cryptoAlgorithm/BatteryPod/BatteryPod.step

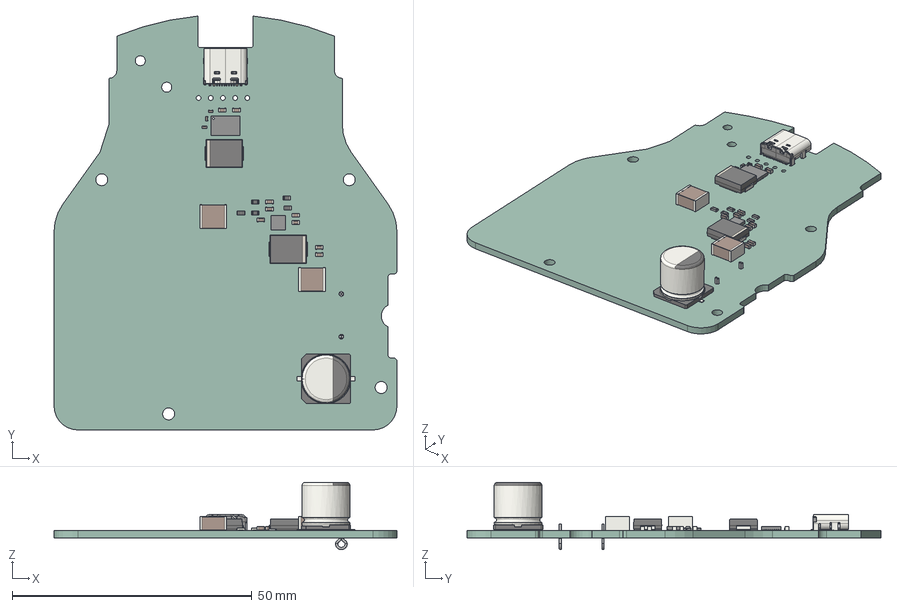
[picture p1: CAD file, 2024-05-07]
BatteryPod.step
71.5 x 86.3 x 14.0 mm
TPS25750DRJKR
C_0603_1608Metric x 9
RTE0016C_ASM
R_0603_1608Metric x 5
C_2220_5650Metric x 2
USB_C_Receptacle_16P_TopMnt_Horizontal_GCT_USB4105-xx-A
D_SMC x 2
C_0402_1005Metric x 3
CP_Elec_10x10
TestPoint_Loop_D2.50mm_Drill1.0mm_LowProfile x 2
BatteryPod_PCB
