cryptoAlgorithm/BatteryPod/3dModels/Coilcraft-SER2918H.STEP

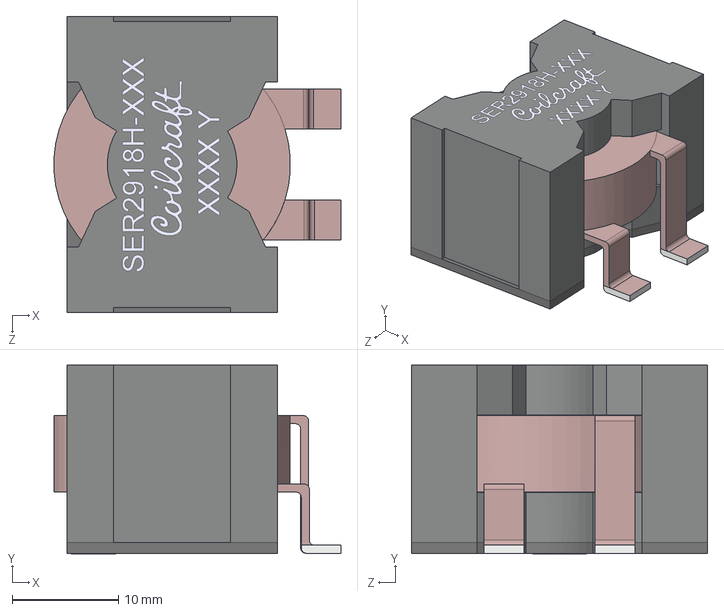
[picture p2: CAD file, 2024-05-01]
3dModels/Coilcraft-SER2918H.STEP
27.0 x 17.8 x 27.9 mm
