cryptoAlgorithm/BatteryPod/3dModels/RTE0016C.stp

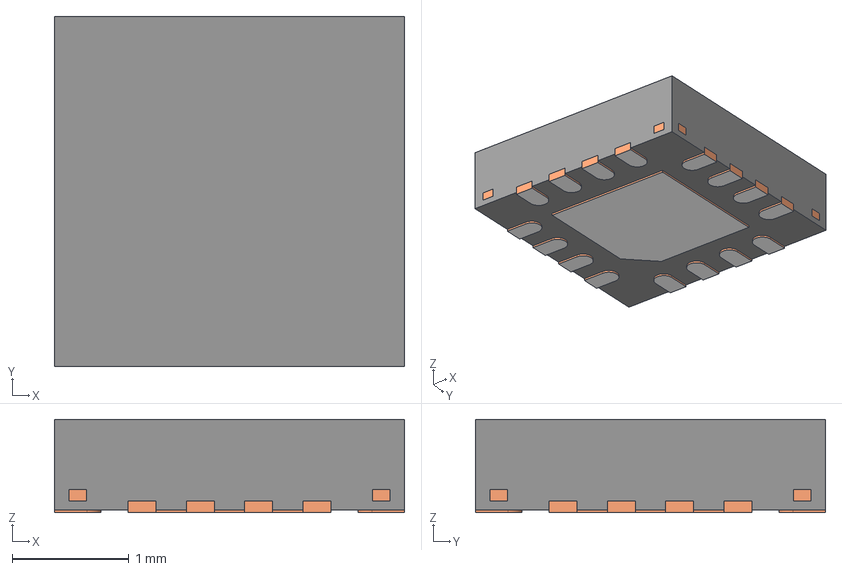
[picture p3: CAD file, 2024-04-30]
3dModels/RTE0016C.stp
3.00 x 3.00 x 0.8 mm
BODY-QFN
FRAME-RTE0016C
PIN1-ID
