cryptoAlgorithm/BatteryPod/3dModels/TPS25750DRJKR.step

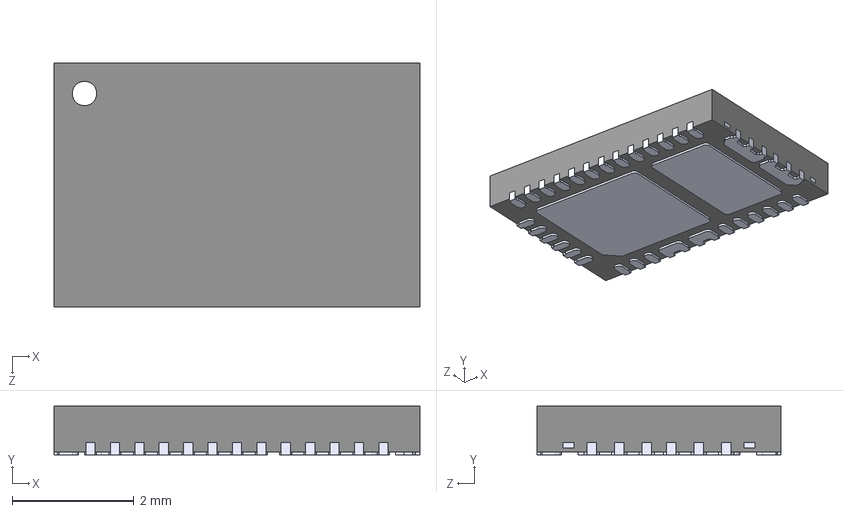
[picture p4: CAD file, 2024-05-06]
3dModels/TPS25750DRJKR.step
6.00 x 0.8 x 4.00 mm
