cryptoAlgorithm/BatteryPod/BatteryPod.kicad_pcb

## KiCad design BatteryPod.kicad_pcb (2024-05-26)

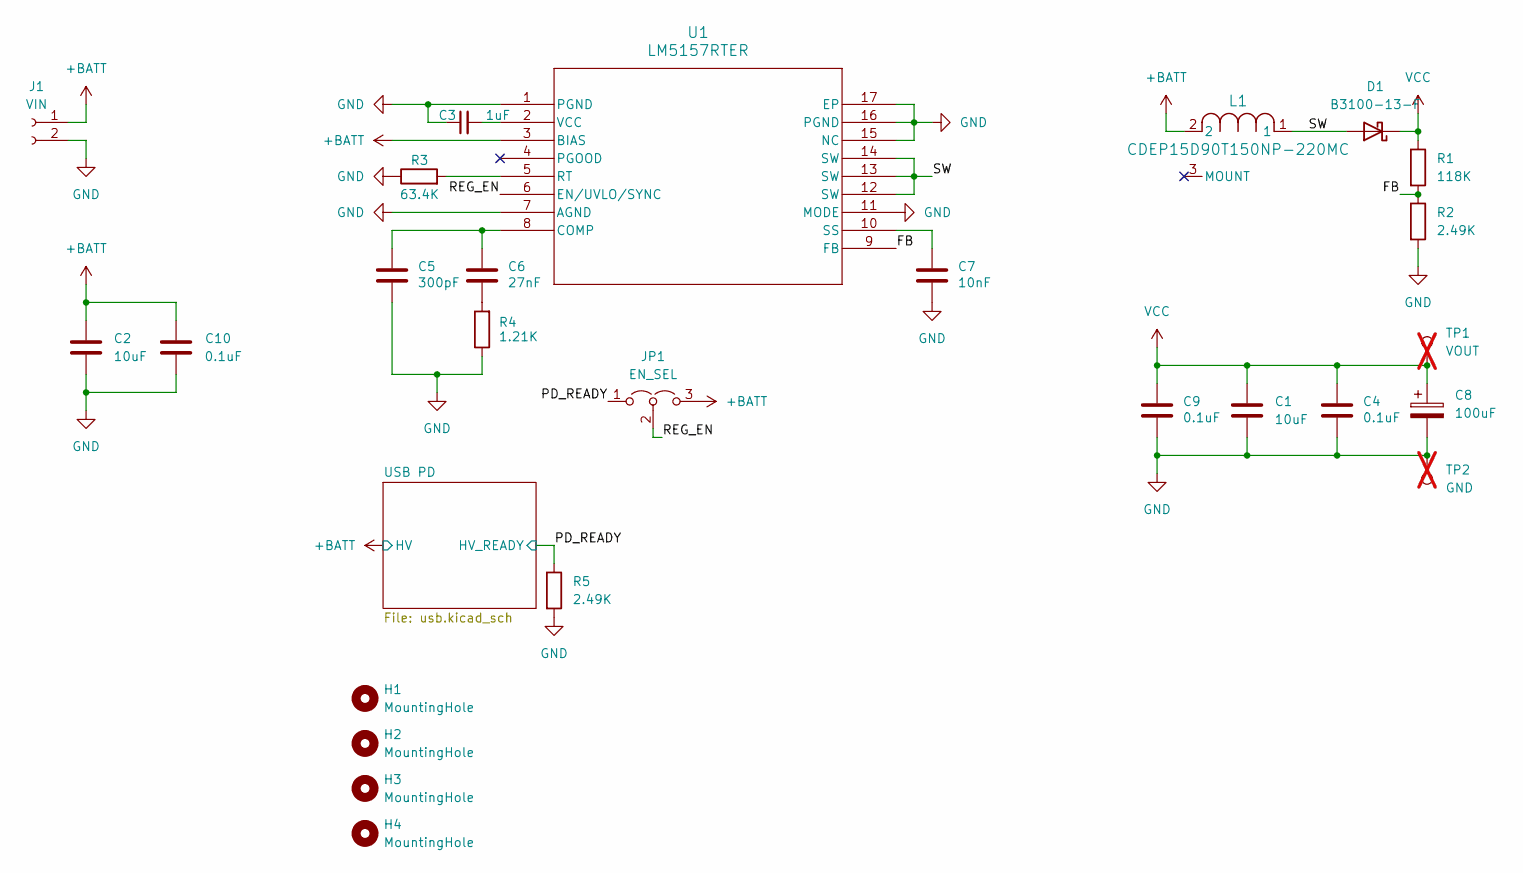
[picture p5: schematic BatteryPod.kicad_sch]

Parts:
C1, C2: 10uF; C_2220_5750Metric; Part C342280
C3: 1uF; C_0603_1608Metric; Part C342988
C4, C9, C10: 0.1uF; C_0603_1608Metric; Part C597287
C5: 300pF; C_0603_1608Metric; Part C159791
C6: 27nF; C_0603_1608Metric; Part C107086
C7: 10nF; C_0603_1608Metric; Part C307347
C8: 100uF; CP_Elec_10x10; Part C487156
D1: B3100-13-F; D_SMC; Part C134447
H1, H2, H3, H4: MountingHole; MountingHole_2.5mm
J1: VIN; SolderWire-1.5sqmm_1x02_P7.8mm_D1.7mm_OD3.9mm
JP1: EN_SEL; PinHeader_1x03_P2.54mm_Vertical
L1: CDEP15D90T150NP-220MC; Part C171581
R1: 118K; R_0603_1608Metric; Part C234251
R2, R5: 2.49K; R_0603_1608Metric; Part C491121
R3: 63.4K; R_0603_1608Metric; Part C218107
R4: 1.21K; R_0603_1608Metric; Part C705737
TP1: VOUT; TestPoint_Loop_D2.50mm_Drill1.0mm_LowProfile; not fitted
TP2: GND; TestPoint_Loop_D2.50mm_Drill1.0mm_LowProfile; not fitted
U1: LM5157RTER; QFN_57RTER_TEX; Part C3188436

Connections:
+BATT: C2.1, C10.2, J1.1, JP1.3 (B), L1.2, U1.3 (BIAS); also elsewhere on the board
/FB: R1.2, R2.1, U1.9 (FB)
/PD_READY: JP1.1 (A), R5.1; also elsewhere on the board
/REG_EN: JP1.2 (C), U1.6 (EN/UVLO/SYNC)
/SW: D1.2 (A), L1.1, U1.12 (SW), U1.13 (SW), U1.14 (SW)
GND: C1.2, C2.2, C3.1, C4.2, C5.2, C7.2, C8.2, C9.2, C10.1, J1.2, R2.2, R3.1, R4.1, R5.2, TP2.1, U1.1 (PGND), U1.7 (AGND), U1.11 (MODE), U1.15 (NC), U1.16 (PGND), U1.17 (EP); also elsewhere on the board
unnamed: C6.2, R4.2
unnamed: C5.1, C6.1, U1.8 (COMP)
unnamed: R3.2, U1.5 (RT)
unnamed: C7.1, U1.10 (SS)
unnamed: C3.2, U1.2 (VCC)
VCC: C1.1, C4.1, C8.1, C9.1, D1.1 (K), R1.1, TP1.1

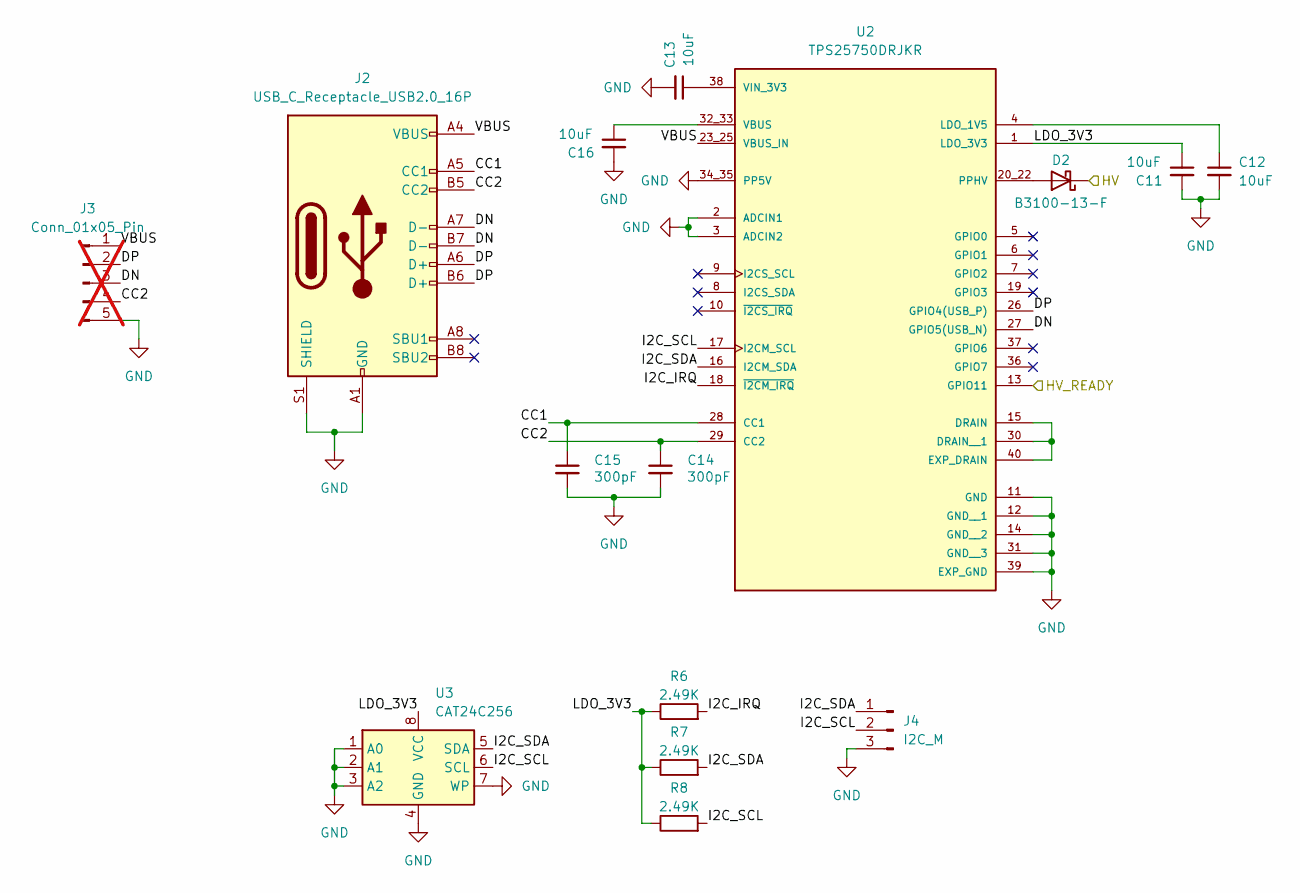
[picture p6: schematic usb.kicad_sch]

Parts:
C11, C12, C13, C16: 10uF; C_0402_1005Metric; Part C2992625
C14, C15: 300pF; C_0603_1608Metric; Part C159791
D2: B3100-13-F; D_SMC; Part C134447
J2: USB_C_Receptacle_USB2.0_16P; USB_C_Receptacle_G-Switch_GT-USB-7010ASV; Part C2843968
J3: Conn_01x05_Pin; PinHeader_1x05_P2.54mm_Vertical; not fitted
J4: I2C_M; PinHeader_1x03_P2.54mm_Vertical
R6, R7, R8: 2.49K; R_0603_1608Metric; Part C491121
U2: TPS25750DRJKR; IC_TPS25750DRJKR; PARTREV A
U3: CAT24C256; SOIC-8_3.9x4.9mm_P1.27mm; Part C79987

Connections:
+BATT: D2.1 (K); also elsewhere on the board
/PD_READY: U2.13 (GPIO11); also elsewhere on the board
/USB PD/CC1: C15.1, J2.A5 (CC1), U2.28 (CC1)
/USB PD/CC2: C14.1, J2.B5 (CC2), J3.4, U2.29 (CC2)
/USB PD/DN: J2.A7 (D-), J2.B7 (D-), J3.3, U2.27 (GPIO5(USB_N))
/USB PD/DP: J2.A6 (D+), J2.B6 (D+), J3.2, U2.26 (GPIO4(USB_P))
/USB PD/I2C_IRQ: R6.2, U2.18 (~I2CM_IRQ)
/USB PD/I2C_SCL: J4.2, R8.2, U2.17 (I2CM_SCL), U3.6 (SCL)
/USB PD/I2C_SDA: J4.1, R7.2, U2.16 (I2CM_SDA), U3.5 (SDA)
/USB PD/LDO_3V3: C11.1, R6.1, R7.1, R8.1, U2.1 (LDO_3V3), U3.8 (VCC)
/USB PD/VBUS: J2.A4 (VBUS), J2.A9 (VBUS), J2.B4 (VBUS), J2.B9 (VBUS), J3.1, U2.23_25 (VBUS_IN)
GND: C11.2, C12.2, C13.2, C14.2, C15.2, C16.2, J2.A1 (GND), J2.A12 (GND), J2.B1 (GND), J2.B12 (GND), J2.S1 (SHIELD), J3.5, J4.3, U2.2 (ADCIN1), U2.3 (ADCIN2), U2.11 (GND), U2.12 (GND__1), U2.14 (GND__2), U2.31 (GND__3), U2.34_35 (PP5V), U2.39 (EXP_GND), U3.1 (A0), U3.2 (A1), U3.3 (A2), U3.4 (GND), U3.7 (WP); also elsewhere on the board
unnamed: D2.2 (A), U2.20_22 (PPHV)
unnamed: U2.15 (DRAIN), U2.30 (DRAIN__1), U2.40 (EXP_DRAIN)
unnamed: C12.1, U2.4 (LDO_1V5)
unnamed: C16.1, U2.32_33 (VBUS)
unnamed: C13.1, U2.38 (VIN_3V3)

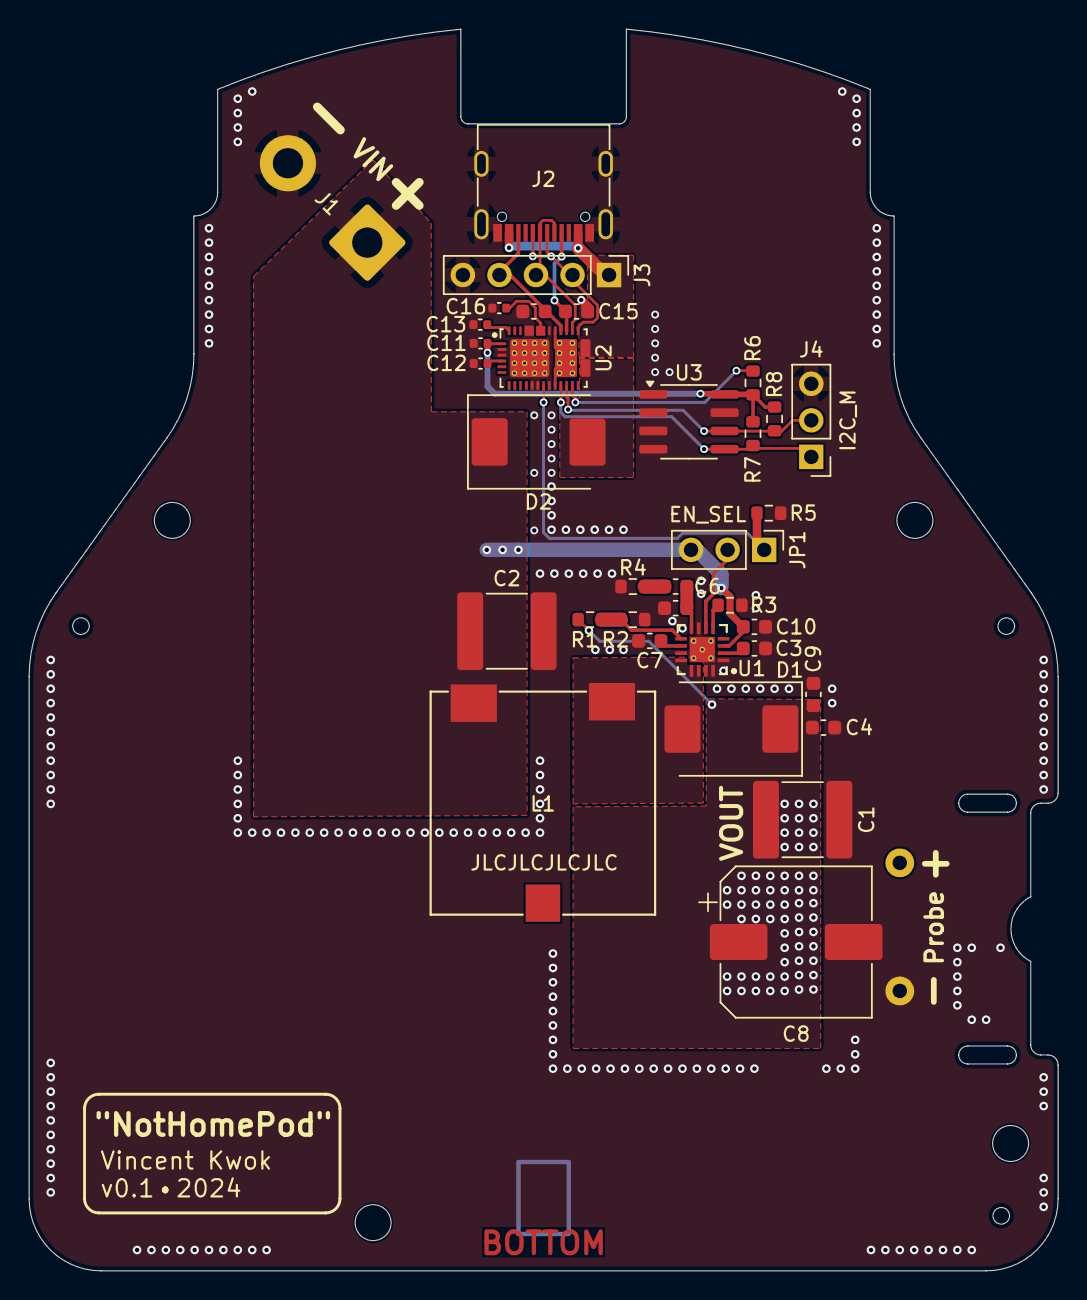
[picture p7: board BatteryPod.kicad_pcb from above]

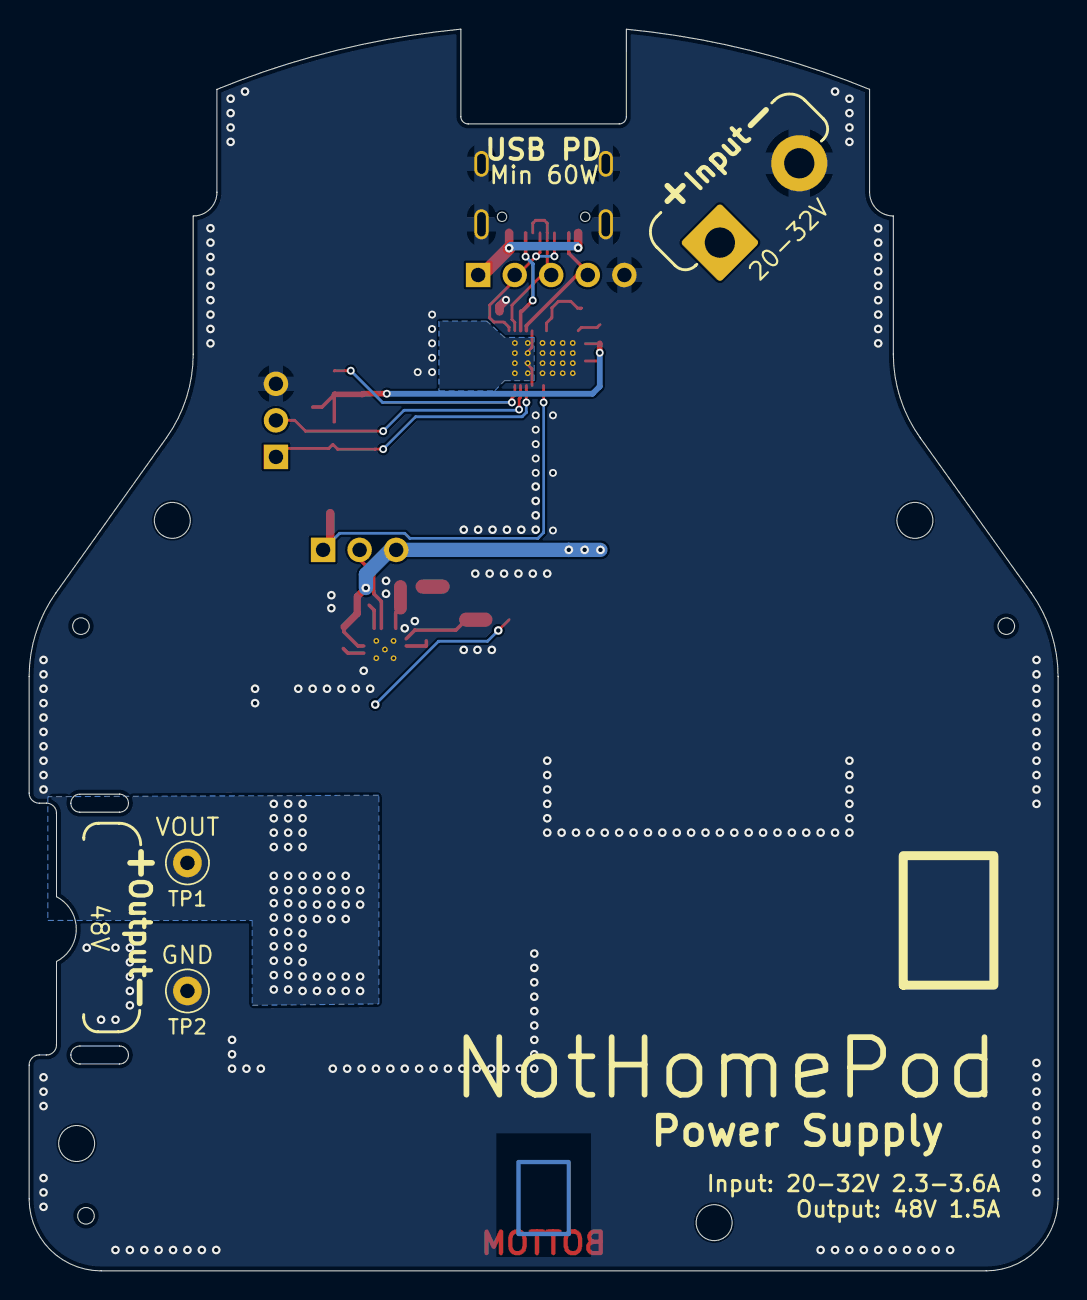
[picture p8: board BatteryPod.kicad_pcb from below]

Board: 2 copper layers, 71.5 x 86.3 mm, 41 parts (6 on the bottom side), 26 nets.
