cryptoAlgorithm/BatteryPod/(commit log)

2024-04-30 feat: inital commit with circuit and board outline
    [BatteryPod.kicad_pcb, BatteryPod.kicad_sch, RTE0016C.stp]
2024-05-01 feat: almost full initial routing
    [BatteryPod-B_Cu.gbl, BatteryPod-B_Mask.gbs, BatteryPod-B_Paste.gbp, BatteryPod-B_Silkscreen.gbo, BatteryPod-Edge_Cuts.gm1, BatteryPod-F_Cu.gtl, BatteryPod-F_Mask.gts, BatteryPod-F_Paste.gtp]
2024-05-01 feat: correct screw positioning (hopefully)
    [BatteryPod.kicad_pcb, BatteryPod.kicad_sch]
2024-05-01 patch: silkscreen improvements fix: screw hole position
    [BatteryPod.kicad_pcb, BatteryPod.kicad_sch]
2024-05-01 feat: add output pads
    [BatteryPod.kicad_pcb]
2024-05-02 feat: move to lower half of board due to high profile inductor this is to match with a recess in the chassis for the higher profile component
    [BatteryPod-B_Cu.gbl, BatteryPod-B_Mask.gbs, BatteryPod-B_Paste.gbp, BatteryPod-B_Silkscreen.gbo, BatteryPod-Edge_Cuts.gm1, BatteryPod-F_Cu.gtl, BatteryPod-F_Mask.gts, BatteryPod-F_Paste.gtp]
2024-05-02 fix: drc errors
    [BatteryPod.kicad_pcb]
2024-05-06 feat: add partial USB-PD input, routing
    [BatteryPod.kicad_pcb, BatteryPod.kicad_sch, BatteryPod.step, TPS25750DRJKR.step, usb.kicad_sch]
2024-05-07 feat: fully routed USB-PD, new lower profile inductor
    [BatteryPod.kicad_pcb, BatteryPod.kicad_sch, BatteryPod.step, usb.kicad_sch]
2024-05-26 patch: final trace cleaups/parameter updates
    [BatteryPod-B_Cu.gbl, BatteryPod-B_Mask.gbs, BatteryPod-B_Paste.gbp, BatteryPod-B_Silkscreen.gbo, BatteryPod-Edge_Cuts.gm1, BatteryPod-F_Cu.gtl, BatteryPod-F_Mask.gts, BatteryPod-F_Paste.gtp]
